spoitras/HHL-abattoir/enclosure.pdf

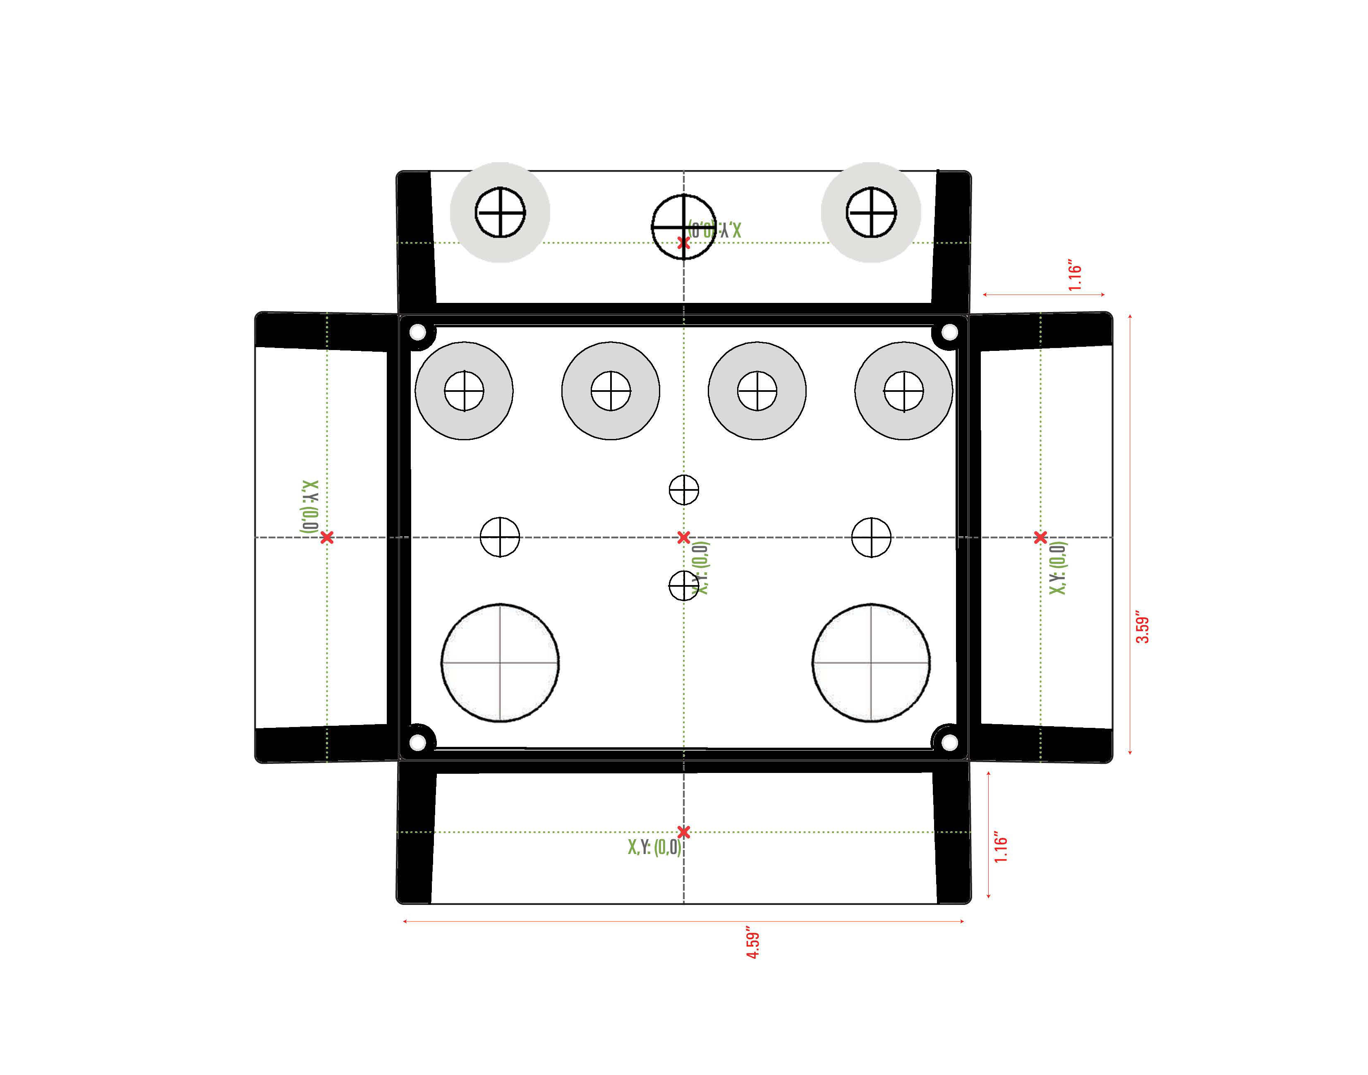
[picture p1: page 1]
