spoitras/HHL-abattoir/Schematic.pdf

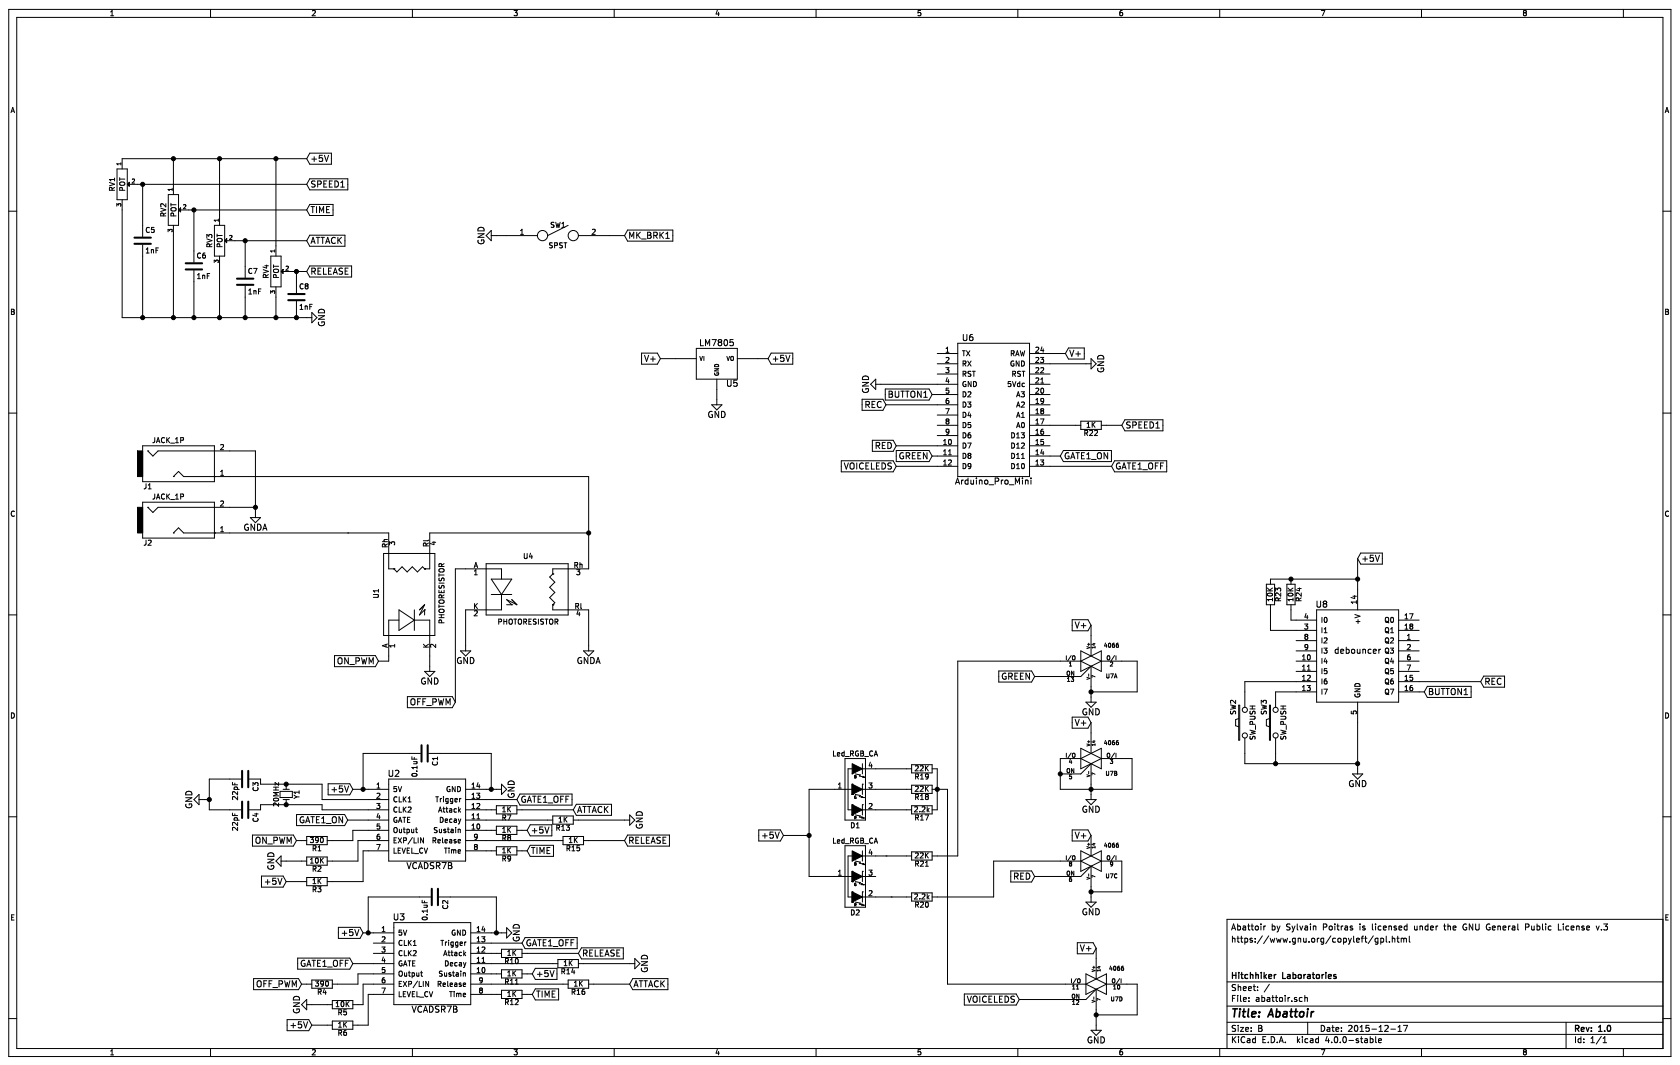
[picture p2: page 1]
